peanat-byte/pocket_radio_v3/_Project_Models/Crystal_SMD_2Pin_11.7x5mm.step

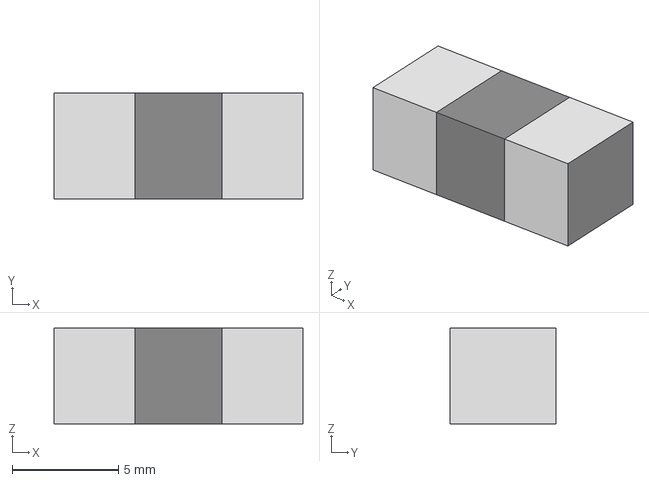
[picture p1: CAD file, 2025-08-05]
_Project_Models/Crystal_SMD_2Pin_11.7x5mm.step
11.7 x 5.00 x 4.50 mm
