peanat-byte/pocket_radio_v3/Case.stl

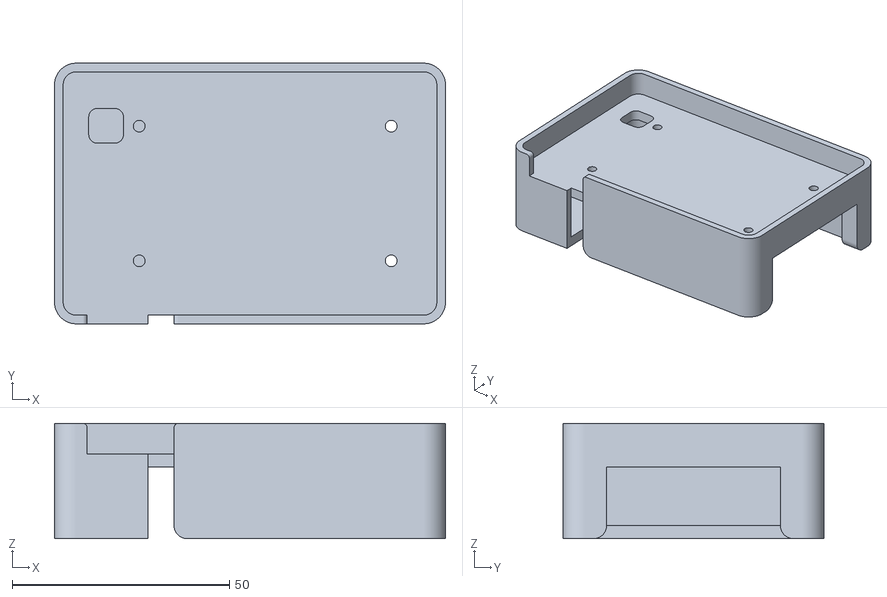
[picture p2: CAD file, 2025-09-07]
Case.stl
90.0 x 60.0 x 26.5
