peanat-byte/pocket_radio_v3/_Project_Models/AudioJackConnector_4Conductor_3.5xL14mm_THT.STEP

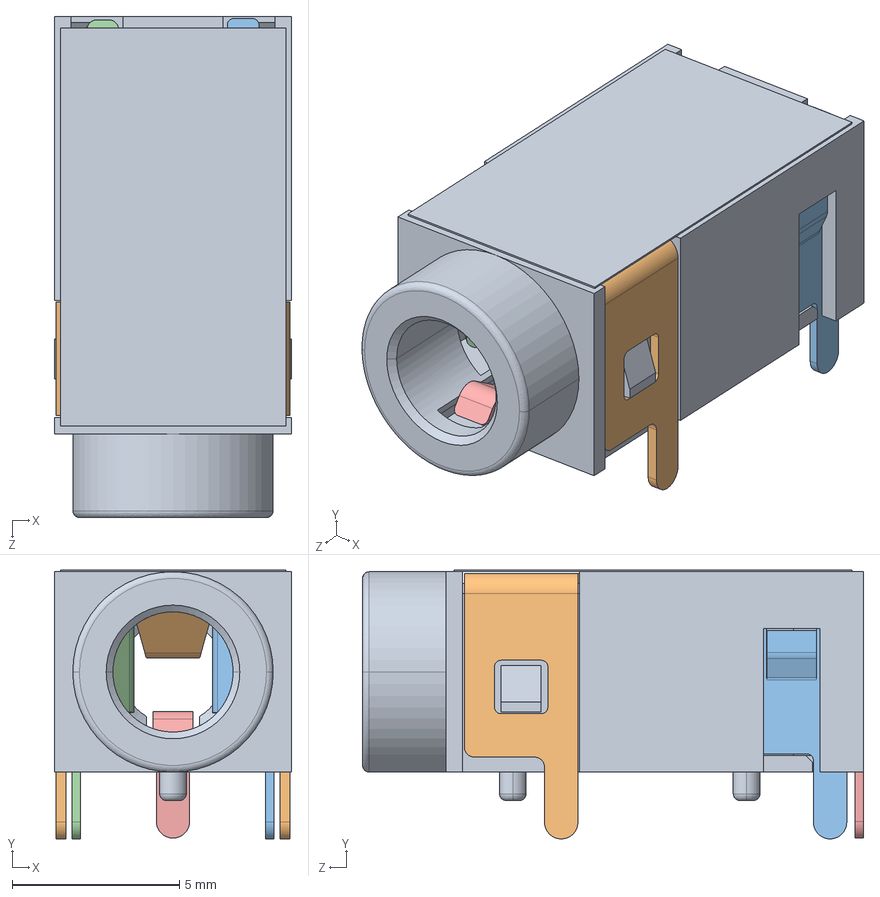
[picture p3: CAD file, 2025-07-28]
_Project_Models/AudioJackConnector_4Conductor_3.5xL14mm_THT.STEP
7.10 x 8.05 x 15.0 mm
54-00174_housing
54-00174_#1
54-00174_#3
54-00174_#2
54-00174_#4
