peanat-byte/pocket_radio_v3/_Project_Models/Skyworks_Si470405-D60_QFN-20_1EP_3x3_P0.5mm.STEP

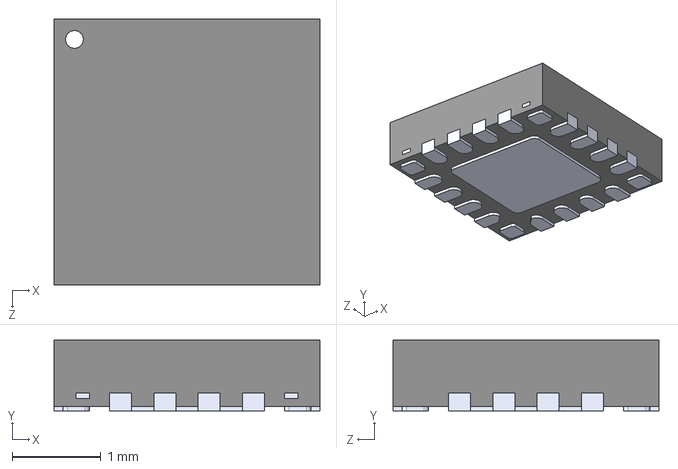
[picture p4: CAD file, 2025-07-28]
_Project_Models/Skyworks_Si470405-D60_QFN-20_1EP_3x3_P0.5mm.STEP
3.00 x 0.8 x 3.00 mm
