peanat-byte/pocket_radio_v3/simulations/Ferrite_sim.asc

C3: cap; 1µ; V=6.3 Irms=0 Rser=0.0109 Lser=230p mfg="Würth Elektronik" pn="885012104011 WCAP-CSGP 0201" type="X5R"
C4: cap; 0.1µ; V=6.3 Irms=0 Rser=0.0337 Lser=180p mfg="Würth Elektronik" pn="885012104009 WCAP-CSGP 0201" type="X5R"
L1: FerriteBead; 2.5µ; Ipk=1 Rser=0.157 Rpar=605 Cpar=1.1p
R1: res; 2; tol=1 pwr=0.1
V1: voltage; ""; AC 1 0
Named nets: 0
.ac lin 1000000 10 10000000000
