peanat-byte/pocket_radio_v3/pocket_radio_v3.kicad_pcb

## KiCad design pocket_radio_v3.kicad_pcb (2025-08-28)

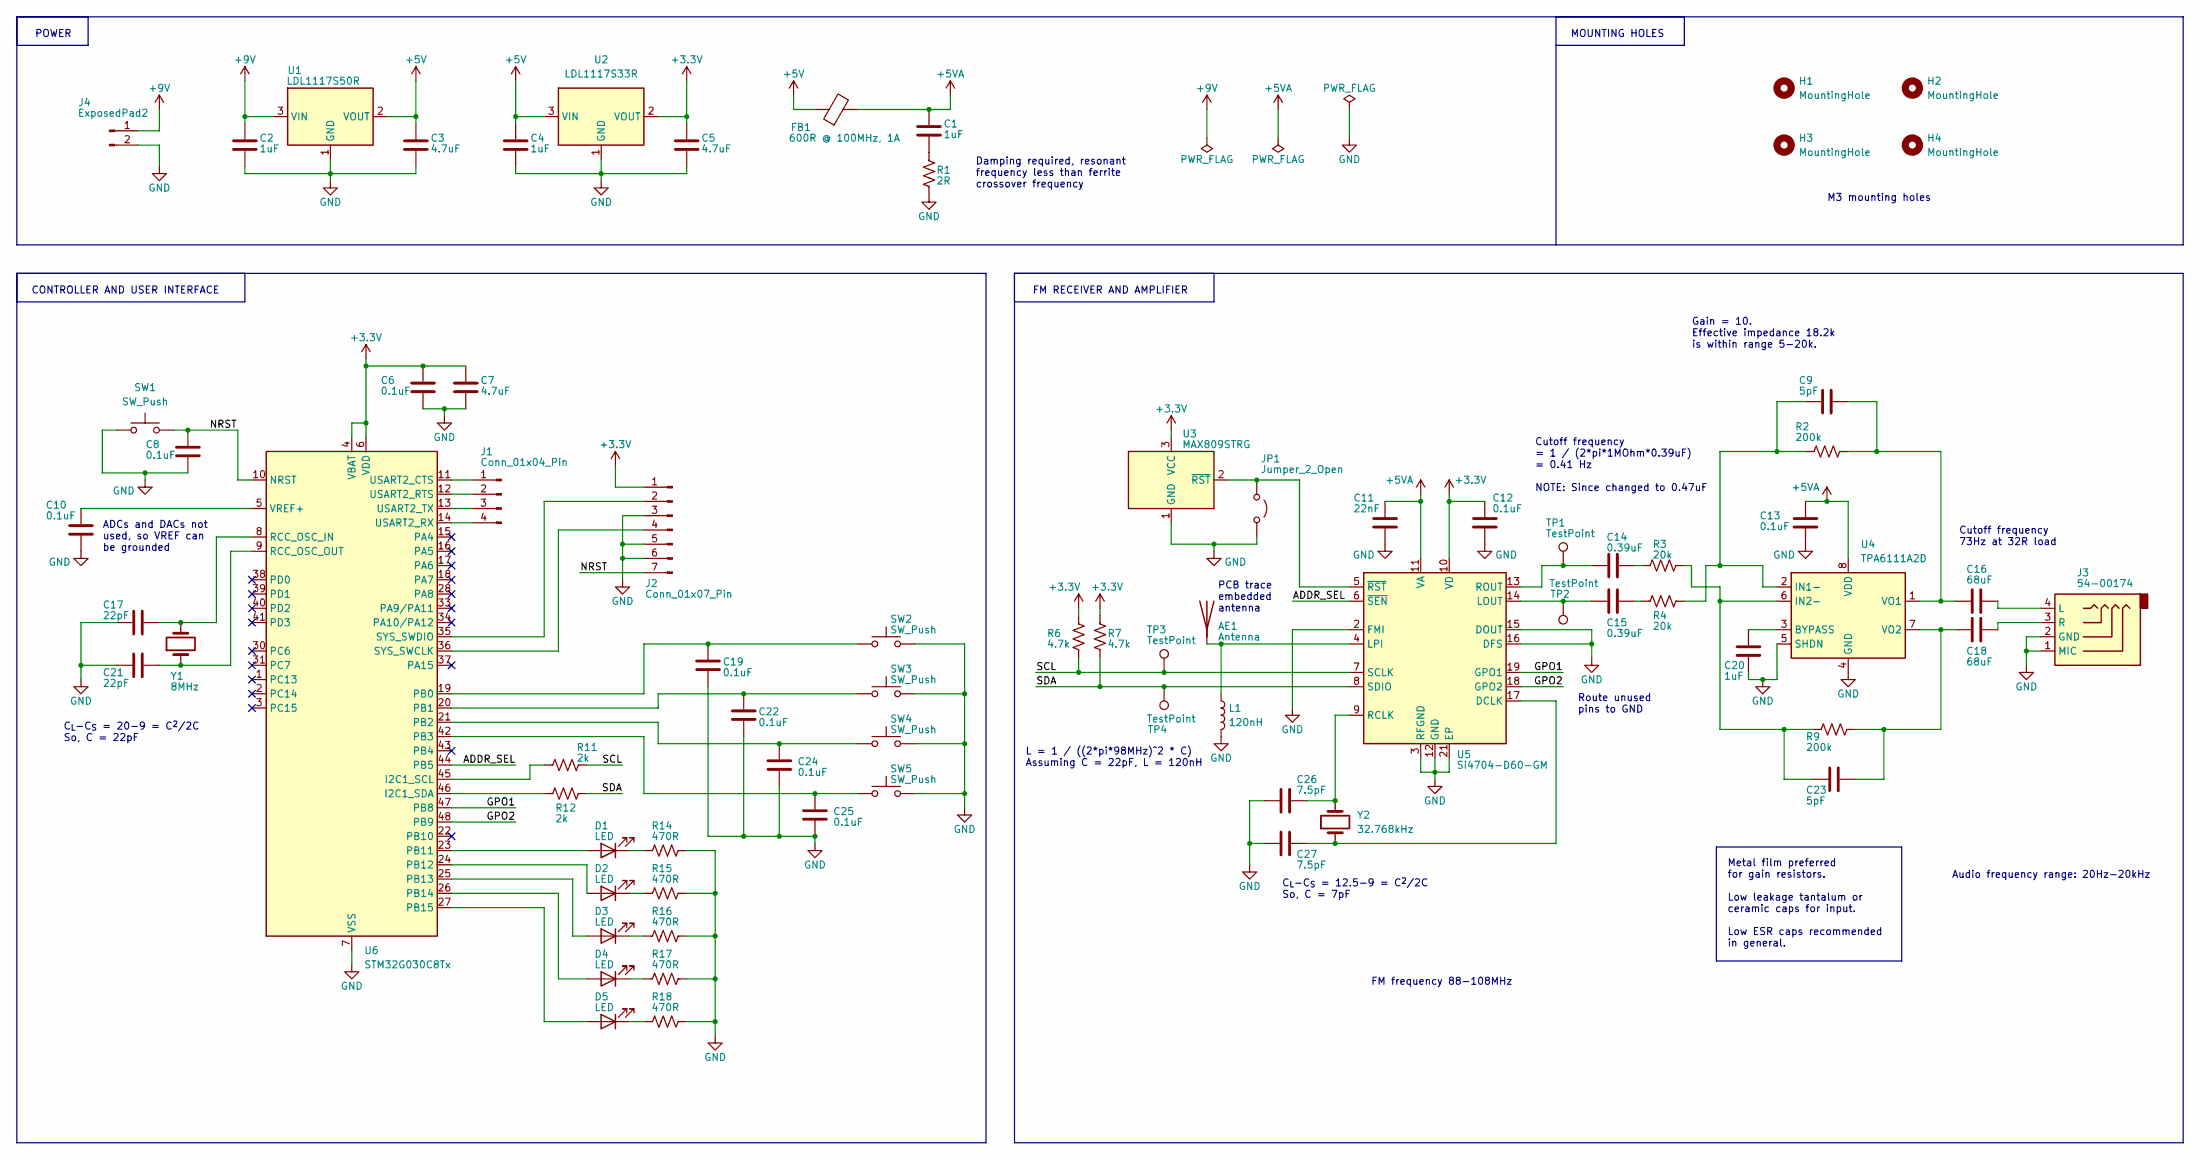
[picture p5: schematic pocket_radio_v3.kicad_sch]

Parts:
AE1: Antenna; EmbeddedAntenna_Si47xx
C1, C2, C4, C20: 1uF; C_0603_1608Metric
C3, C5, C7: 4.7uF; C_0603_1608Metric
C6, C8, C10, C12, C13, C19, C22, C24, C25: 0.1uF; C_0402_1005Metric
C9, C23: 5pF; C_0603_1608Metric
C11: 22nF; C_0402_1005Metric
C14, C15: 0.39uF; C_0603_1608Metric
C16, C18: 68uF; C_1210_3225Metric
C17, C21: 22pF; C_0402_1005Metric
C26, C27: 7.5pF; C_0402_1005Metric
D1, D2, D3, D4, D5: LED; D_0603_1608Metric
FB1: 600R @ 100MHz, 1A; L_0603_1608Metric
H1, H2, H3, H4: MountingHole; MountingHole_3.2mm_M3_ISO7380
J1: Conn_01x04_Pin; PinHeader_1x04_P2.54mm_Vertical_Tight
J2: Conn_01x07_Pin; PinHeader_1x07_P2.54mm_Vertical_Tight
J3: 54-00174; AudioJackConnector_4Conductor_3.5xL14mm_THT
J4: ExposedPad2; ExposedPad_2Conn_2x3mm_P3mm
JP1: Jumper_2_Open; ViaJumper_Pitch2.54mm_Drill0.7mm
L1: 120nH; L_0603_1608Metric
R1: 2R; R_0603_1608Metric
R2, R9: 200k; R_0805_2012Metric
R3, R4: 20k; R_0603_1608Metric
R6, R7: 4.7k; R_0603_1608Metric
R11, R12: 2k; R_0603_1608Metric
R14, R15, R16, R17, R18: 470R; R_0603_1608Metric
SW1, SW2, SW3, SW4, SW5: SW_Push; SW_SPST_PTS647_Sx38
TP1, TP2, TP3, TP4: TestPoint; TestPoint_Pad_D1.5mm
U1: LDL1117S50R; SOT-223-3_TabPin2
U2: LDL1117S33R; SOT-223-3_TabPin2
U3: MAX809STRG; SOT-23-3
U4: TPA6111A2D; SOIC-8_3.9x4.9mm_P1.27mm
U5: Si4704-D60-GM; Skyworks_Si470405-D60_QFN-20_1EP_3x3_P0.5mm
U6: STM32G030C8Tx; LQFP-48_7x7mm_P0.5mm
Y1: 8MHz; Crystal_SMD_2Pin_11.7x5mm
Y2: 32.768kHz; Crystal_SMD_3215-2Pin_3.2x1.5mm

Connections:
+3.3V: C5.1, C6.1, C7.1, C12.1, J2.1, R6.2, R7.2, U2.2 (VOUT), U3.3 (VCC), U5.10 (VD), U6.4 (VBAT), U6.6 (VDD)
+5V: C3.1, C4.1, FB1.1, U1.2 (VOUT), U2.3 (VIN)
+5VA: C1.1, C11.2, C13.1, FB1.2, U4.8 (VDD), U5.11 (VA)
+9V: C2.1, J4.1, U1.3 (VIN)
/ADDR_SEL: U5.6 (~SEN), U6.44 (PB5)
/GPO1: U5.19 (GPO1), U6.47 (PB8)
/GPO2: U5.18 (GPO2), U6.48 (PB9)
/NRST: C8.1, J2.7, SW1.2, U6.10 (NRST)
/SCL: R6.1, R11.1, TP3.1, U5.7 (SCLK)
/SDA: R7.1, R12.1, TP4.1, U5.8 (SDIO)
GND: C2.2, C3.2, C4.2, C5.2, C6.2, C7.2, C8.2, C10.2, C11.1, C12.2, C13.2, C17.1, C19.2, C20.2, C21.1, C22.2, C24.2, C25.2, C26.1, C27.1, J2.3, J2.5, J2.6, J3.1 (MIC), J3.2 (GND), J4.2, JP1.2 (B), L1.2, R1.1, R14.1, R15.1, R16.1, R17.1, R18.1, SW1.1, SW2.2, SW3.2, SW4.2, SW5.2, U1.1 (GND), U2.1 (GND), U3.1 (GND), U4.4 (GND), U4.5 (SHDN), U5.2 (FMI), U5.3 (RFGND), U5.12 (GND), U5.15 (DOUT), U5.16 (DFS), U5.21 (EP), U6.7 (VSS)
unnamed: AE1.1 (A), L1.1, U5.4 (LPI)
unnamed: C1.2, R1.2
unnamed: C14.1, R3.2
unnamed: C15.1, R4.2
unnamed: D1.2 (A), U6.23 (PB11)
unnamed: D1.1 (K), R14.2
unnamed: D2.2 (A), U6.24 (PB12)
unnamed: D2.1 (K), R15.2
unnamed: D3.2 (A), U6.25 (PB13)
unnamed: D3.1 (K), R16.2
unnamed: D4.2 (A), U6.26 (PB14)
unnamed: D4.1 (K), R17.2
unnamed: D5.2 (A), U6.27 (PB15)
unnamed: D5.1 (K), R18.2
unnamed: J1.1, U6.11 (USART2_CTS)
unnamed: J1.2, U6.12 (USART2_RTS)
unnamed: J1.3, U6.13 (USART2_TX)
unnamed: J1.4, U6.14 (USART2_RX)
unnamed: J2.2, U6.35 (SYS_SWDIO)
unnamed: J2.4, U6.36 (SYS_SWCLK)
unnamed: C16.1, J3.4 (L)
unnamed: C18.1, J3.3 (R)
unnamed: JP1.1 (A), U3.2 (~RST), U5.5 (~RST)
unnamed: C20.1, U4.3 (BYPASS)
unnamed: C9.2, R2.2, R4.1, U4.2 (IN1-)
unnamed: C23.2, R3.1, R9.2, U4.6 (IN2-)
unnamed: C9.1, C16.2, R2.1, U4.1 (VO1)
unnamed: C18.2, C23.1, R9.1, U4.7 (VO2)
unnamed: C27.2, U5.17 (DCLK), Y2.1
unnamed: C15.2, TP2.1, U5.14 (LOUT)
unnamed: C26.2, U5.9 (RCLK), Y2.2
unnamed: C14.2, TP1.1, U5.13 (ROUT)
unnamed: C19.1, SW2.1, U6.19 (PB0)
unnamed: C22.1, SW3.1, U6.20 (PB1)
unnamed: C24.1, SW4.1, U6.21 (PB2)
unnamed: C25.1, SW5.1, U6.42 (PB3)
unnamed: R11.2, U6.45 (I2C1_SCL)
unnamed: R12.2, U6.46 (I2C1_SDA)
unnamed: C17.2, U6.8 (RCC_OSC_IN), Y1.2
unnamed: C21.2, U6.9 (RCC_OSC_OUT), Y1.1
unnamed: C10.1, U6.5 (VREF+)

Notes on the sheet:
Audio frequency range: 20Hz-20kHz
Cutoff frequency 73Hz at 32R load
C_{L}-C_{S} = 20-9 = C^{2}/2C So, C = 22pF
L = 1 / ((2*pi*98MHz)^2 * C) Assuming C = 22pF, L = 120nH
Route unused pins to GND
Gain = 10. Effective impedance 18.2k is within range 5-20k.
FM frequency 88-108MHz
Metal film preferred for gain resistors. Low leakage tantalum or ceramic caps for input. Low ESR caps recommended in general.
FM RECEIVER AND AMPLIFIER
PCB trace embedded antenna
CONTROLLER AND USER INTERFACE
Damping required, resonant frequency less than ferrite crossover frequency
ADCs and DACs not used, so VREF can be grounded
M3 mounting holes
Cutoff frequency = 1 / (2*pi*1MOhm*0.39uF) = 0.41 Hz NOTE: Since changed to 0.47uF
C_{L}-C_{S} = 12.5-9 = C^{2}/2C So, C = 7pF
MOUNTING HOLES
POWER

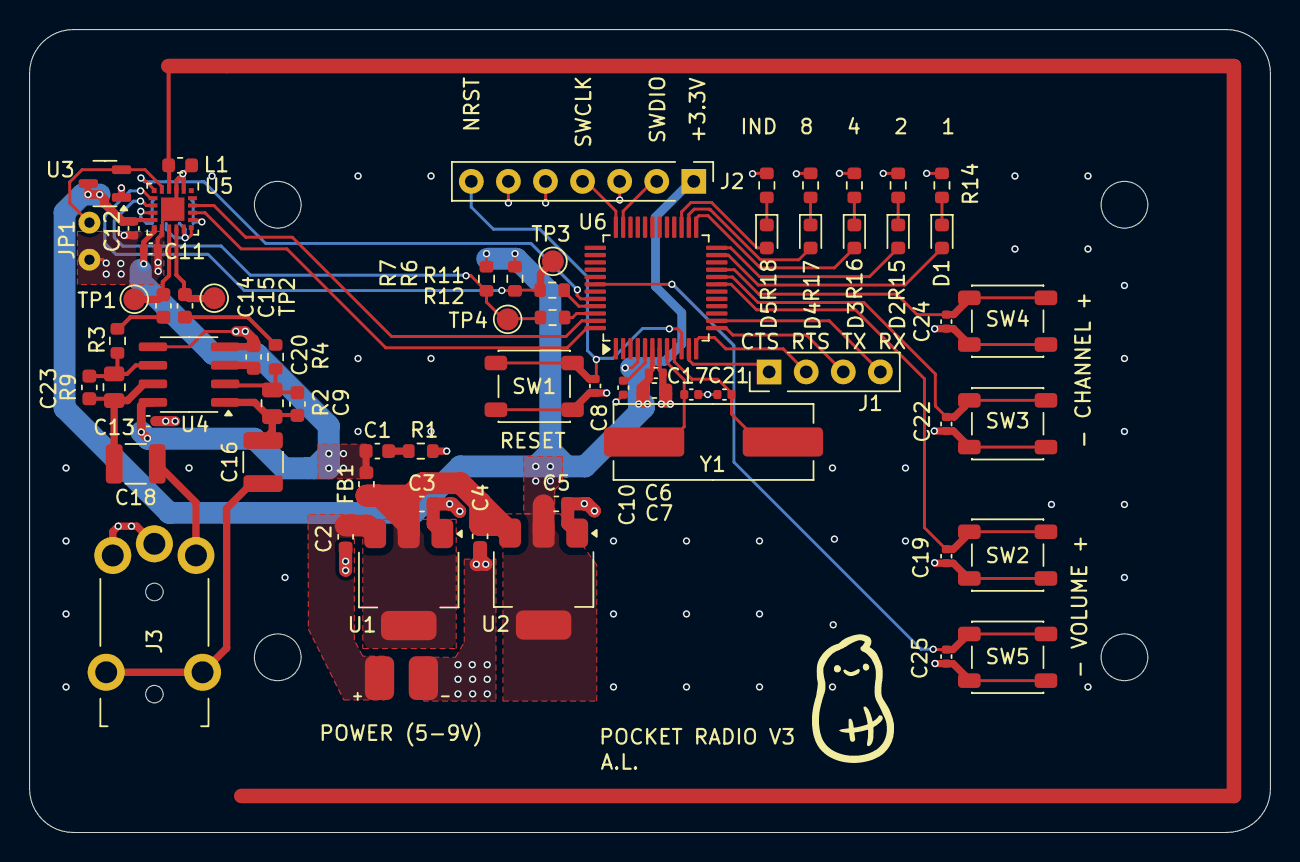
[picture p6: board pocket_radio_v3.kicad_pcb from above]

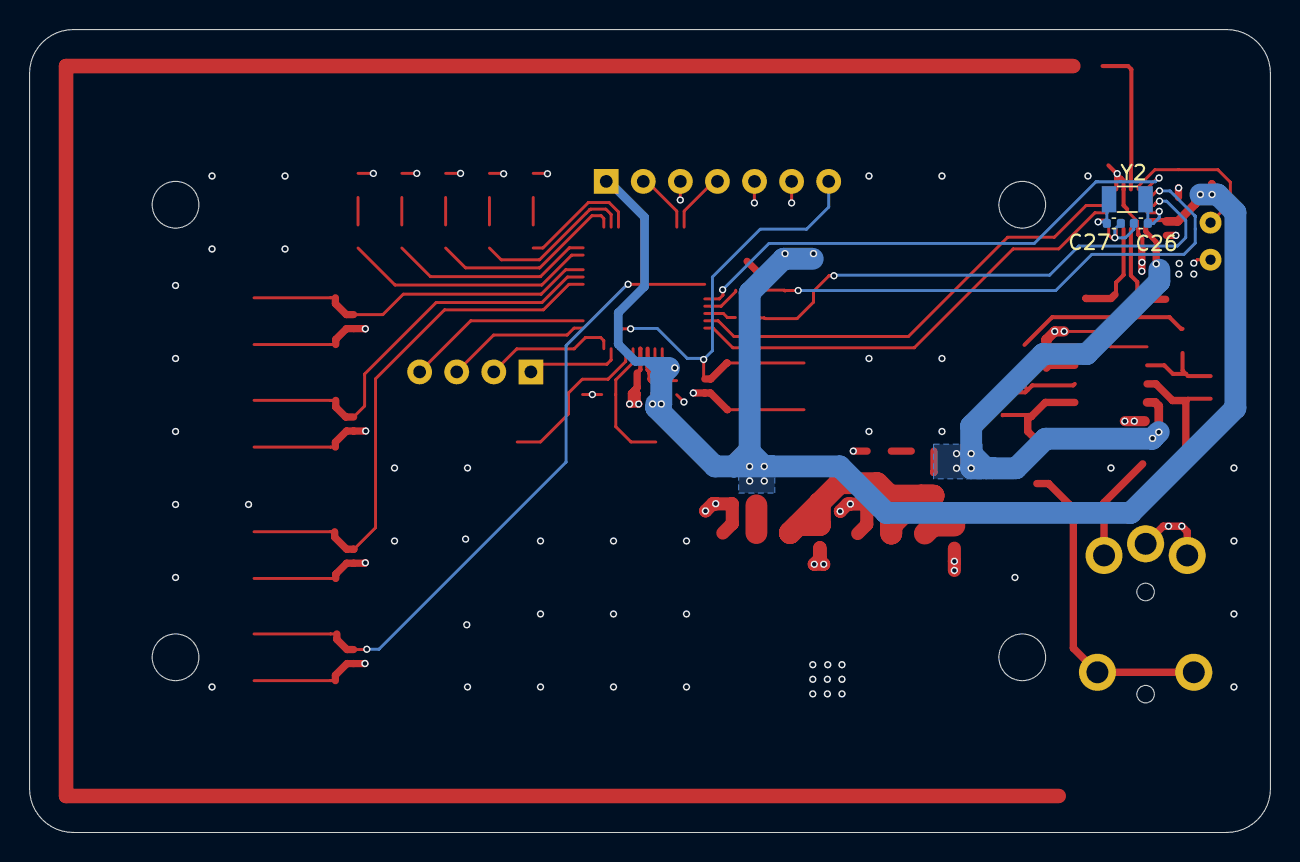
[picture p7: board pocket_radio_v3.kicad_pcb from below]

Board: 4 copper layers, 85.0 x 55.0 mm, 75 parts (3 on the bottom side), 52 nets.
