peanat-byte/pocket_radio_v3/fw/pocket_radio_v3/Core/Src/main.c

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
/* Includes ------------------------------------------------------------------*/
#include "main.h"

/* USER CODE BEGIN Includes */
#include <stdio.h>
#include <string.h>
/* USER CODE END Includes */

/* USER CODE BEGIN PD */
#define ADDR 0x22
/* USER CODE END PD */

I2C_HandleTypeDef hi2c1;

UART_HandleTypeDef huart2;

/* USER CODE BEGIN PV */
volatile uint16_t volume = 0x001E;

/* USER CODE END PV */

void SystemClock_Config(void);
static void MX_GPIO_Init(void);
static void MX_I2C1_Init(void);
static void MX_USART2_UART_Init(void);
/* USER CODE BEGIN PFP */
void Print_UART(char *str);
void Power_Up(void);
void Get_Rev(void);
void Set_Property(uint16_t property, uint16_t value);
void Get_Property(void);
void Tune_Freq(uint16_t channel);
void Tune_Status(void);
void Seek_Start(uint8_t up);
void GPIO_Ctl(void);
void GPIO_Set(void);
uint8_t Read_Status(void);
void Wait_For_CTS(void);
/* USER CODE END PFP */

/* USER CODE BEGIN 0 */
void HAL_GPIO_EXTI_Falling_Callback(uint16_t GPIO_Pin)
{
	if (GPIO_Pin == CHAN_M_Pin)
	{
		Seek_Start(0);   // Seek down
	}
	else if (GPIO_Pin == CHAN_P_Pin)
	{
		Seek_Start(1);   // Seek up
	}
	else if (GPIO_Pin == VOL_M_Pin)
	{
		volume -= 5;
		if (volume < 5)
		{
			volume = 5;
		}
		// RX_VOLUME 0x4000 allowed 0-63, set to volume
	    Set_Property(0x4000, volume);
	}
	else if (GPIO_Pin == VOL_P_Pin)
	{
		volume += 5;
		if (volume > 60)
		{
			volume = 60;
		}
		// RX_VOLUME 0x4000 allowed 0-63, set to volume
		Set_Property(0x4000, volume);
	}
}
/* USER CODE END 0 */

/**
  * @brief  The application entry point.
  * @retval int
  */
int main(void)
{

  /* MCU Configuration--------------------------------------------------------*/

  /* Reset of all peripherals, Initializes the Flash interface and the Systick. */
  HAL_Init();

  /* Configure the system clock */
  SystemClock_Config();

  /* Initialize all configured peripherals */
  MX_GPIO_Init();
  MX_I2C1_Init();
  MX_USART2_UART_Init();
  /* Infinite loop */
  /* USER CODE BEGIN WHILE */
  while (1)
  {
	  HAL_GPIO_WritePin(GPIOB, IND_Pin, GPIO_PIN_SET);
	  HAL_Delay(1000);

	  char msg[64];
	  sprintf(msg, "I'M ALIVEEEE\r\n");
	  Print_UART(msg);

	  Power_Up();
	  Get_Rev();

	  // Set GPOs low to avoid oscillation and excessivie current consumption
	  GPIO_Ctl();
	  GPIO_Set();

	  // RX_VOLUME 0x4000 allowed 0-63, set to 30 (0x001E)
	  Set_Property(0x4000, 0x001E);
	  HAL_Delay(100);

	  // FM_ANTENNA_INPUT 0x1107 0x0001 (LPI antenna input)
	  Set_Property(0x1107, 0x0001);
	  HAL_Delay(100);

	  Tune_Freq(10350);
	  Tune_Status();

	  while (1)
	  {
		  HAL_Delay(10000);
	  }

    /* USER CODE END WHILE */

    /* USER CODE BEGIN 3 */
  }
  /* USER CODE END 3 */
}

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
/* USER CODE BEGIN 4 */
void Print_UART(char *str)
{
  HAL_UART_Transmit(&huart2, (uint8_t*)str, strlen(str), HAL_MAX_DELAY);
}

/*
* CMD 0x01 (POWER_UP)
* ARG1 0x10
* 	CTSIEN 0 (disable interrupt)
* 	GPO2OEN 0 (disable GPO2)
* 	PATCH 0 (boot normally)
* 	XOSCEN 1 (use crystal oscillator)
* 	FUNC 0 (FM receive)
* ARG2 0x05 (00000101 analog audio output)
*/
void Power_Up(void)
{
  uint8_t cmd[3] = {0x01, 0x10, 0x05};  // CMD, ARG1, ARG2
  HAL_I2C_Master_Transmit(&hi2c1, ADDR, cmd, sizeof(cmd), HAL_MAX_DELAY);
  HAL_Delay(100);  // wait for CTS to go high hopefully
}

/*
* CMD 0x10 (GET_REV)
* Response: STATUS + 15 bytes
*/
void Get_Rev(void)
{
  uint8_t cmd = 0x10;
  uint8_t resp[16] = {0};

  HAL_I2C_Master_Transmit(&hi2c1, ADDR, &cmd, 1, HAL_MAX_DELAY);

  HAL_Delay(100); // Hopefully CTS set by now

  HAL_I2C_Master_Receive(&hi2c1, ADDR, resp, 16, HAL_MAX_DELAY);

  char msg[64];
  sprintf(msg, "STATUS: 0x%02X\r\n", resp[0]);
  Print_UART(msg);
  sprintf(msg, "Part Number: %d\r\n", resp[1]);
  Print_UART(msg);
  sprintf(msg, "FW Major: %d\r\n", resp[2]);
  Print_UART(msg);
  sprintf(msg, "FW Minor: %d\r\n", resp[3]);
  int patchID = (resp[4] << 8) | resp[5];
  sprintf(msg, "Patch ID: %d\r\n", patchID);
  Print_UART(msg);
  sprintf(msg, "Comp Major: %d\r\n", resp[6]);
  Print_UART(msg);
  sprintf(msg, "Comp Minor: %d\r\n", resp[7]);
  Print_UART(msg);
  sprintf(msg, "Chip Rev: %d\r\n", resp[8]);
  Print_UART(msg);
}

/*
* CMD 0x12 (SET_PROPERTY)
* ARG1 0x00
* ARG2 (property high byte)
* ARG3 (property low byte)
* ARG4 (value high byte)
* ARG5(value low byte)
*
* Properties:
* 	FM_ANTENNA_INPUT 0x1107 0x0001 (LPI antenna input)
* 	RX_VOLUME 0x4000 0-63 (dec)
*/
void Set_Property(uint16_t property, uint16_t value)
{
  uint8_t cmd[6] = {0x12, 0x00, (property >> 8) & 0xFF, property & 0xFF, (value >> 8) & 0xFF, value & 0xFF};
  HAL_I2C_Master_Transmit(&hi2c1, ADDR, cmd, sizeof(cmd), HAL_MAX_DELAY);
//  HAL_Delay(100);
}

void Get_Property(void)
{
  // TODO
}

/*
* CMD 0x20 (FM_TUNE_FREQ)
* ARG1 0x00
* 	FREEZE 0 (bit 1)
* 	FAST 0 (bit 0)
* ARG2 (channel high byte)
* ARG3 (channel low byte)
* ARG4 0x00 (set antenna tuning cap automatically)
*
* @param channel in 10kHz units from 64-108MHz
*/
void Tune_Freq(uint16_t channel)
{
  uint8_t FREQ_H = (channel >> 8) & 0xFF;
  uint8_t FREQ_L = channel & 0xFF;
  uint8_t cmd[5] = {0x20, 0x00, FREQ_H, FREQ_L, 0x00};
  HAL_I2C_Master_Transmit(&hi2c1, ADDR, cmd, sizeof(cmd), HAL_MAX_DELAY);
  HAL_Delay(100);
}

/*
* CMD 0x22
* ARG1 0x00
* 	CANCEL 0 (don't cancel seek) (bit 1)
* 	INTACK 0 (don't clear seek/tune interrupt status indicator) (bit 0)
*/
void Tune_Status(void)
{
  uint8_t cmd[2] = {0x22, 0x00};
  HAL_I2C_Master_Transmit(&hi2c1, ADDR, cmd, sizeof(cmd), HAL_MAX_DELAY);
  HAL_Delay(100);

  uint8_t resp[8] = {0};
  HAL_I2C_Master_Receive(&hi2c1, ADDR, resp, 8, HAL_MAX_DELAY);

  char msg[64];
  sprintf(msg, "RESP1: 0x%02X\r\n", resp[1]);
  Print_UART(msg);
  int freq = (resp[2] << 8) | resp[3];
  sprintf(msg, "Read frequency: %d\r\n", freq);
  Print_UART(msg);
  sprintf(msg, "RSSI: %d\r\n", resp[4]);
  Print_UART(msg);
  sprintf(msg, "SNR: %d\r\n", resp[5]);
  Print_UART(msg);
  sprintf(msg, "READANTCAP: %d\r\n", resp[7]);
  Print_UART(msg);
}

/*
 * CMD 0x21 (FM_SEEK_START)
 * ARG1 0x0C
 *	 SEEKUP 1 (bit 3)
 *	 WRAP 1 (bit 2)
 *
 * @param up: 1 to seek up, 0 to seek down
 */
void Seek_Start(uint8_t up)
{
    uint8_t arg1 = 0x04;
    if (up) {
        arg1 |= 0x08;
    }

	uint8_t cmd[2] = {0x21, arg1};
	HAL_I2C_Master_Transmit(&hi2c1, ADDR, cmd, sizeof(cmd), HAL_MAX_DELAY);

//	char msg[64];
//	sprintf(msg, "Seeking...\r\n");
//	Print_UART(msg);
}

/*
 * CMD 0x80
 * ARG1 0x06
 *   GPO3EN 0
 *   GPO2EN 1
 *   GPO1EN 1
 *
 * Note: GPO3 is overridden by DCLK.
 * The other two should be drive low to avoid oscillation.
 */
void GPIO_Ctl(void)
{
	uint8_t cmd[2] = {0x80, 0x06};
	HAL_I2C_Master_Transmit(&hi2c1, ADDR, cmd, sizeof(cmd), HAL_MAX_DELAY);
	HAL_Delay(100);
}

/*
 * CMD 0x81
 * ARG1 0x00
 *   GPO3LEVEL 0
 *   GPO2LEVEL 0
 *   GPO1LEVEL 0
 */
void GPIO_Set(void)
{
	uint8_t cmd[2] = {0x81, 0x00};
	HAL_I2C_Master_Transmit(&hi2c1, ADDR, cmd, sizeof(cmd), HAL_MAX_DELAY);
	HAL_Delay(100);
}

uint8_t Read_Status(void)
{
  uint8_t status = 0;
  HAL_I2C_Master_Receive(&hi2c1, ADDR, &status, 1, HAL_MAX_DELAY);
  return status;
}

void Wait_For_CTS(void)
{
  uint8_t status;
  do {
	  status = Read_Status();
	  HAL_Delay(100);
  } while ((status & 0x80) == 0); // While CTS bit low

  // Print status
  char msg[32];
  sprintf(msg, "CTS high, STATUS = 0x%02X\r\n", status);
  Print_UART(msg);
}

/* USER CODE END 4 */
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
