peanat-byte/pocket_radio_v3/fw/pocket_radio_v3/Core/Inc/main.h

#define VOL_P_Pin GPIO_PIN_0
#define VOL_P_GPIO_Port GPIOB
#define VOL_P_EXTI_IRQn EXTI0_1_IRQn
#define CHAN_M_Pin GPIO_PIN_1
#define CHAN_M_GPIO_Port GPIOB
#define CHAN_M_EXTI_IRQn EXTI0_1_IRQn
#define CHAN_P_Pin GPIO_PIN_2
#define CHAN_P_GPIO_Port GPIOB
#define CHAN_P_EXTI_IRQn EXTI2_3_IRQn
#define DIG1_Pin GPIO_PIN_11
#define DIG1_GPIO_Port GPIOB
#define DIG2_Pin GPIO_PIN_12
#define DIG2_GPIO_Port GPIOB
#define DIG4_Pin GPIO_PIN_13
#define DIG4_GPIO_Port GPIOB
#define DIG8_Pin GPIO_PIN_14
#define DIG8_GPIO_Port GPIOB
#define IND_Pin GPIO_PIN_15
#define IND_GPIO_Port GPIOB
#define VOL_M_Pin GPIO_PIN_3
#define VOL_M_GPIO_Port GPIOB
#define VOL_M_EXTI_IRQn EXTI2_3_IRQn
#define ADDR_SEL_Pin GPIO_PIN_5
#define ADDR_SEL_GPIO_Port GPIOB
#define GPO1_Pin GPIO_PIN_8
#define GPO1_GPIO_Port GPIOB
#define GPO2_Pin GPIO_PIN_9
#define GPO2_GPIO_Port GPIOB
