peanat-byte/pocket_radio_v3/(commit log)

2025-07-28 Upload WIP
    [AudioJackConnector_4Conductor_3.5xL14mm_THT.STEP, Skyworks_Si470405-D60_QFN-20_1EP_3x3_P0.5mm.STEP, pocket_radio_v3.kicad_pcb, pocket_radio_v3.kicad_sch]
2025-07-31 Amost done schematic
    [pocket_radio_v3.kicad_sch]
2025-08-01 Schematic mostly done
    [pocket_radio_v3.kicad_sch]
2025-08-05 Start layout, add sim files
    [Crystal_SMD_2Pin_11.7x5mm.step, pocket_radio_v3.kicad_pcb, pocket_radio_v3.kicad_sch]
2025-08-07 Done layout, except for cosmetics and stitching vias
    [pocket_radio_v3.kicad_pcb]
2025-08-08 Done and create fab files
    [pocket_radio_v3-B_Cu.gbl, pocket_radio_v3-B_Mask.gbs, pocket_radio_v3-B_Paste.gbp, pocket_radio_v3-B_Silkscreen.gbo, pocket_radio_v3-Edge_Cuts.gm1, pocket_radio_v3-F_Cu.gtl, pocket_radio_v3-F_Mask.gts, pocket_radio_v3-F_Paste.gtp]
2025-08-28 Start fw project
    [pocket_radio_v3.kicad_pcb]
2025-09-03 Add volume and channel button functionality
2025-09-07 GPO low, case stl file
    [Case.stl]
