peanat-byte/pocket_radio_v3/(notices)

Notices in the files:
fw/pocket_radio_v3/Core/Src/main.c:
Copyright (c) 2025 STMicroelectronics.
All rights reserved.
This software is licensed under terms that can be found in the LICENSE file
